LoZioo/RoboticSystems-Project/README.md

# RoboticSystems-Project
RoboticSystems project repository by Davide Scalisi and Luigi Seminara.

## Directory organization
-	`/datasheets`:	ICs datasheets.
-	`/docs`:				documentation of the project.
-	`/lib`:				libraries used inside this project; you can find test files under `/test`.
-	`/schematics`:	wiring diagrams.
-	`/src`:				source code for both MCUs.
