LoZioo/RoboticSystems-Project/src/QuadratureSignal/README.md

# QuadratureSignal
Simple sketch to emulate the quadrature output signal of a rotary encoder.
