LoZioo/RoboticSystems-Project/ToDo.md

# To-Do List

## Arduino Nano
-	Fare Readme di tutte le librerie.
-	Rivedere file README di RI32.
-	Tarare tutti i PID.
-	Mettere nel brief la descrizione delle librerie.

## ESP32
