LoZioo/RoboticSystems-Project/src/RoboticSystems-Project/ESP32/include/const.h

//Protocol and app CPU.
#define PRO_CPU	0
#define APP_CPU	1

#define MAX_WIFI_ATTEMPTS	5
#define SOFTAP_SSID				"RoboticSystems-Project"

//Device settings.
struct settings_t{
	char ssid[32];
	char pass[32];
};
