LoZioo/RoboticSystems-Project/src/RoboticSystems-Project/ATmega328/include/utils.h

/**
 * @file utils.h
 * @author Davide Scalisi
 * @brief 
 * @version 0.1
 * @date 2022-08-01
 * 
 * @copyright Copyright (c) 2022
 * 
 * Set of auxiliary functions.
 */

#ifndef UTILS_H
#define UTILS_H

#include <Arduino.h>

inline float normalize_angle(float a){
	while(a > PI)
		a -= 2 * PI;
	
	while(a < -PI)
		a += 2 * PI;
	
	return a;
}

inline void cartesian_to_polar(float &x, float &y){
	float rho = sqrt(square(x) + square(y));
	float theta = atan2(y, x);

	x = rho;
	y = theta;
}

#endif
