LoZioo/RoboticSystems-Project/(commit log)

2022-06-25 feat: added schematics for H-Bridge driver board
    [H_bridge_controller.kicad_pcb, H_bridge_controller.kicad_sch]
2022-06-30 feat: added shematics for the Nano control board.
    [Nano_board.kicad_pcb, Nano_board.kicad_sch]
2022-07-05 feat: updated Nano board schematics.
    [Nano_board.kicad_sch]
2022-07-05 feat: updated H_bridge_controller schematics.
    [H_bridge_controller.kicad_sch]
2022-07-08 feat: fixed schematics and updated LMD18200 library.
    [Nano_board.kicad_sch]
2022-07-12 fix: added pull-down resistors to the H_bridge_controller schematics.
    [H_bridge_controller.kicad_sch]
2022-07-15 feat: reworked RI32 structure and main code.
    [const.h, main.cpp]
2022-07-16 feat: added PID class and fixed RI32 odomerty class.
    [const.h, main.cpp]
2022-07-26 docs: added docs for speed controller schematics.
2022-07-26 docs: updated speed controller schematics.
2022-07-30 refactor: LMD18200 is now using Phase Correct PWM.
2022-07-30 fix: DELTA_T dropped from 1kHz to 125Hz.
    [const.h, main.cpp]
2022-07-30 fix: 0m/s speed controller fix.
    [main.cpp]
2022-08-01 docs: updated control schematics.
2022-08-01 fix: fixed PID with zero-saturation.
2022-08-02 fix: commented unused constants.
    [const.h]
2022-08-11 feat: added PID default values.
2022-08-16 feat: added WebSerial ESP32 project.
2022-08-16 feat: robot controlled by WebSerial ESP32.
2022-08-20 feat: added EEPROM PID constants saving commands.
2022-08-20 fix: auto re-enable engine when writing PWM>0...
2022-08-20 fix: added lin_speed and ang_speed for the two PID
2022-08-31 fix: fixed esp32-cam OTA upload error.
2022-08-31 feat: added first revision of ESP32 code.
